santiagoatejeda/Pleper/Imágenes Proyecto/Desarrollo/Tareas manuales/Agujerear la placa de caucho.jpg

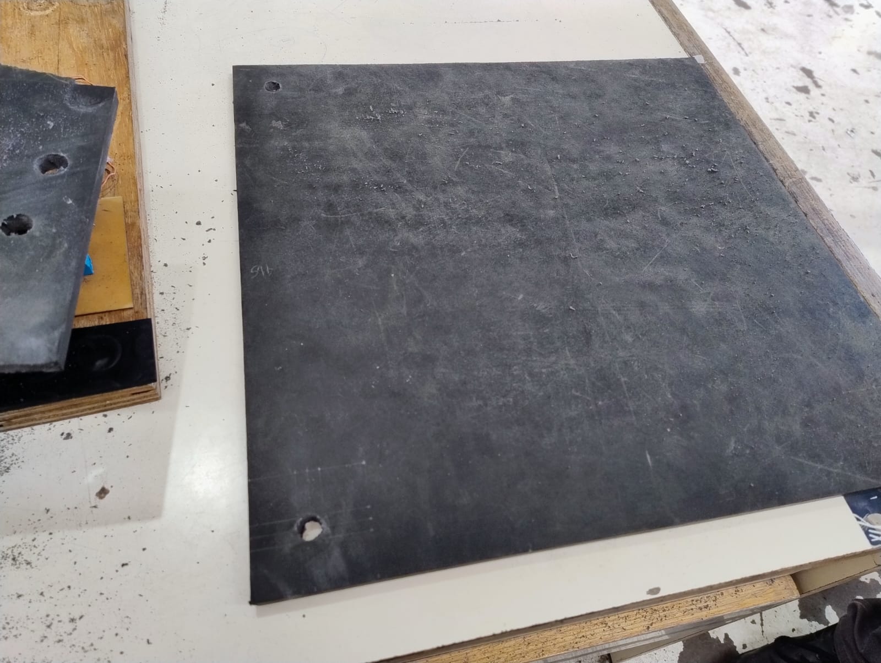
Imágenes Proyecto/Desarrollo/Tareas manuales/Agujerear la placa de caucho.jpg
