santiagoatejeda/Pleper/Diseño de placas/readme.md

# Carpeta: Diseño de Placas

> Módulos electrónicos del proyecto

---

## Contenido
- `Banco de capacitores/` → Conjunto de capacitores conectados en paralelo para almacenamiento de energía.  
- `Diseño 3D/` → Modelado tridimensional del banco de capacitores y disposición general.  
- `Placa rectificadora/` → Conversión de corriente alterna a continua para carga estable en la batería.
- `Raspberry (Placa para el display)` → Mostrar la tensión generada y crear una página para mostrarla.  
- `Segunda placa rectificadora` → Conversión de corriente alterna a continua para carga estable; placa para la segunda baldosa.
  
---

## Descripción
En esta carpeta se encuentran los **diseños electrónicos** fundamentales del sistema:  
- Implementación de **etapas de rectificación y almacenamiento**.  
- Integración entre módulos para alimentar el sistema de medición y visualización.  

---

## Herramientas utilizadas
- **KiCad** para diseño de PCBs.  
- **PDFGear** para visualización e impresión.
---
