santiagoatejeda/Pleper/Diseño y modelos 3D/readme.md

# Carpeta: Diseño y modelos 3D

> Planos y diseños del proyecto
> Realizados en **AutoCAD** para el modelado y la disposición del sistema piezoeléctrico.

---

## Descripción
Aquí se desarrollan los **planos 2D y modelos 3D** del prototipo:  
- Distribución de sensores piezoeléctricos   
- Soporte mecánico y otros elementos en impresión 3D
- Cables, conexiones y espacio para batería   

---

## Herramientas utilizadas
- AutoCAD 2025  
- FreeCAD (para pruebas de exportación STEP)
