santiagoatejeda/Pleper/Documentos Proyecto/readme.md

# Carpeta: Documentos del Proyecto

> Archivos y registros del proyecto  
> Incluye documentación técnica, bitácoras, materiales de referencia y presentaciones finales.

---

## Contenido
- `Anteproyecto, Objetivos e Historias de Usuario` → Primeros documentos técnicos que buscaban guíar hacía donde iría el desarrollo del proyecto.  
- `Bitácora y Carpeta de Campo/` → Registro cronológico del avance mensual y tareas realizadas.  
- `CV Alumnos/` → Curriculum de los integrantes del proyecto.  
- `Carpeta Técnica y Manual de Usuario/` → Documentación técnica explicativa sobre el proyecto.  
- `Compras/` → Comprobantes, presupuestos y control de materiales adquiridos.    
- `Material/` → Referencias teóricas, papers y fuentes consultadas.  
- `Video de presentación/` → Guion, recursos y edición del video final del proyecto.  

---

## Herramientas utilizadas
- Microsoft Word y PowerPoint  
- Canva (diseño visual del material)  
- Google Drive
- Excel
