santiagoatejeda/Pleper/Imágenes Proyecto/readme.md

# Carpeta: Imágenes del Proyecto

> Registro visual del proyecto
> Fotografías, capturas y material gráfico que documenta cada etapa de desarrollo.

---

## Contenido
- `Desarrollo/` → Imágenes del prototipo en construcción y pruebas de funcionamiento.  
- `Referencias/` → Material visual de apoyo, esquemas base y ejemplos consultados.  
- `Instagram/` → Contenido audiovisual editado para difusión del proyecto.  

---

## Descripción
Esta carpeta concentra todo el **material gráfico y visual** del proyecto, utilizado tanto para documentación técnica como para difusión.  
Incluye: fotos del armado y conexión de placas, imágenes promocionales y contenido para redes  

---
