santiagoatejeda/Pleper/Documentos Proyecto/Elementos de alcance inconclusos.docx

Elementos de alcance inconclusos

Enunciado

El alcance de un proyecto se refiere al conjunto de límites y fronteras que definen lo que se incluye y lo que no se incluye en un proyecto específico. Estos límites pueden estar relacionados con el tiempo, los recursos, las funciones y las características del producto o servicio a desarrollar. En otras palabras, el alcance del proyecto establece los límites y las expectativas para el trabajo que se llevará a cabo durante el ciclo de vida del proyecto.

En el camino del desarrollo del proyecto, han enfrentado desafíos significativos. Sin embargo, es crucial que reflexionemos sobre nuestro progreso hasta ahora y abordemos las tareas pendientes de manera transparente.

Con tal fin le vamos a pedir que en un documento que van a pasarnos, enumeren los diferentes elementos que quedaron afuera en cuanto a entregables y características que se esperaban el principio de desarrollo y que al final no pudieron ser llevadas a cabo. Pueden discriminar entre cada una de estas cosas el motivo asociado y la idea es que lo presenten de una manera relativamente sencilla.

Es crucial la transparencia en este punto puesto que se definirá en caso de crear cosas importantes pendientes los límites de ellas a fin de poder trabajarlo en un plazo acotado.

Elemento pendiente | Descripción breve | Motivo de no concreción
Alimentar una batería con la energía generada | Se buscaba almacenar la energía que generaba la placa en una batería para su posterior uso | La corriente generada era bastante menor a la esperada en un principio con la distribución de los piezoeléctricos, por lo que requeríamos realizar más baldosas
Mostrar en el display la energía almacenada | Poder mostrar la carga almacenada en la batería | Al no haber implementado una batería, no podemos mostrar de manera interactiva el display. Sin embargo, logramos hacer que mostrara los picos de tensión almacenados
Integración con aplicación móvil | Se esperaba mostrar datos de energía generada en una app. | Finalmente los datos pasaron a mostrarse en una web generada en el momento gracias a la pi pico 2W y conectandose a un wifi local. En esta página se podrían ver los picos de tensión que se generan en tiempo real al pisar la baldosa.
Alimentar el microcontrolador con una batería Lipo y un módulo de carga | Se esperaba alimentar la raspberry pi pico 2W con una batería Lipo y un módulo de carga. | Lo que ocurrió fue que la batería Lipo alimentaba hasta 4,1V mientras que la pico necesitaba 5V. Al querer usar una batería de mayor voltaje, experimentamos una serie de falsos contactos en el modulo de carga y al final optamos por una batería portátil.
Memoria limitada de la pico | Se esperaba crearle un apartado web a la pico para que muestre los picos de tensión en tiempo real, tanto en el display como en la página que crearía en el momento. | Hubo un problema y era que nuestra idea del apartado web era mostrar los picos de tensión, que los picos mayores a 1V se congelen por un breve tiempo (para que la gente lo pueda ver) y agregar una grafica para que la gente vea de forma mas interactiva los picos de tensión que generaba. El grafico no lo pudimos hacer con buenas características o mas complejo (como especificaciones técnicas) por la limitada memoria que experimento la pi pico 2W.
Presentar nuestro prototipo en las ONIET | buscábamos poder presentar nuestro prototipo en las ONIET | Debido a un problema de tiempos, no llegábamos preparados para presentar en optimas condiciones el prototipo para la exposición de las ONIET. Finalmente llegamos a exponer en condiciones para la feria anual del IMPA, pero a las ONIET no pudimos llegar.
Hacer mas baldosas | Hacer mas baldosas para poder cargar el cartel de salida de emergencias | El objetivo inicial era mostrar el cartel de salida de emergencias prendido por la carga de energía proveniente de las baldosas, sin embargo, requeríamos de una cantidad mayor de baldosas para cumplir dicho objetivo. Finalmente decidimos únicamente mostrar los picos de tensión generados.
