santiagoatejeda/Pleper/Documentos Proyecto/CV Alumnos/Currículum Vitae de Isidro Stabile.pdf

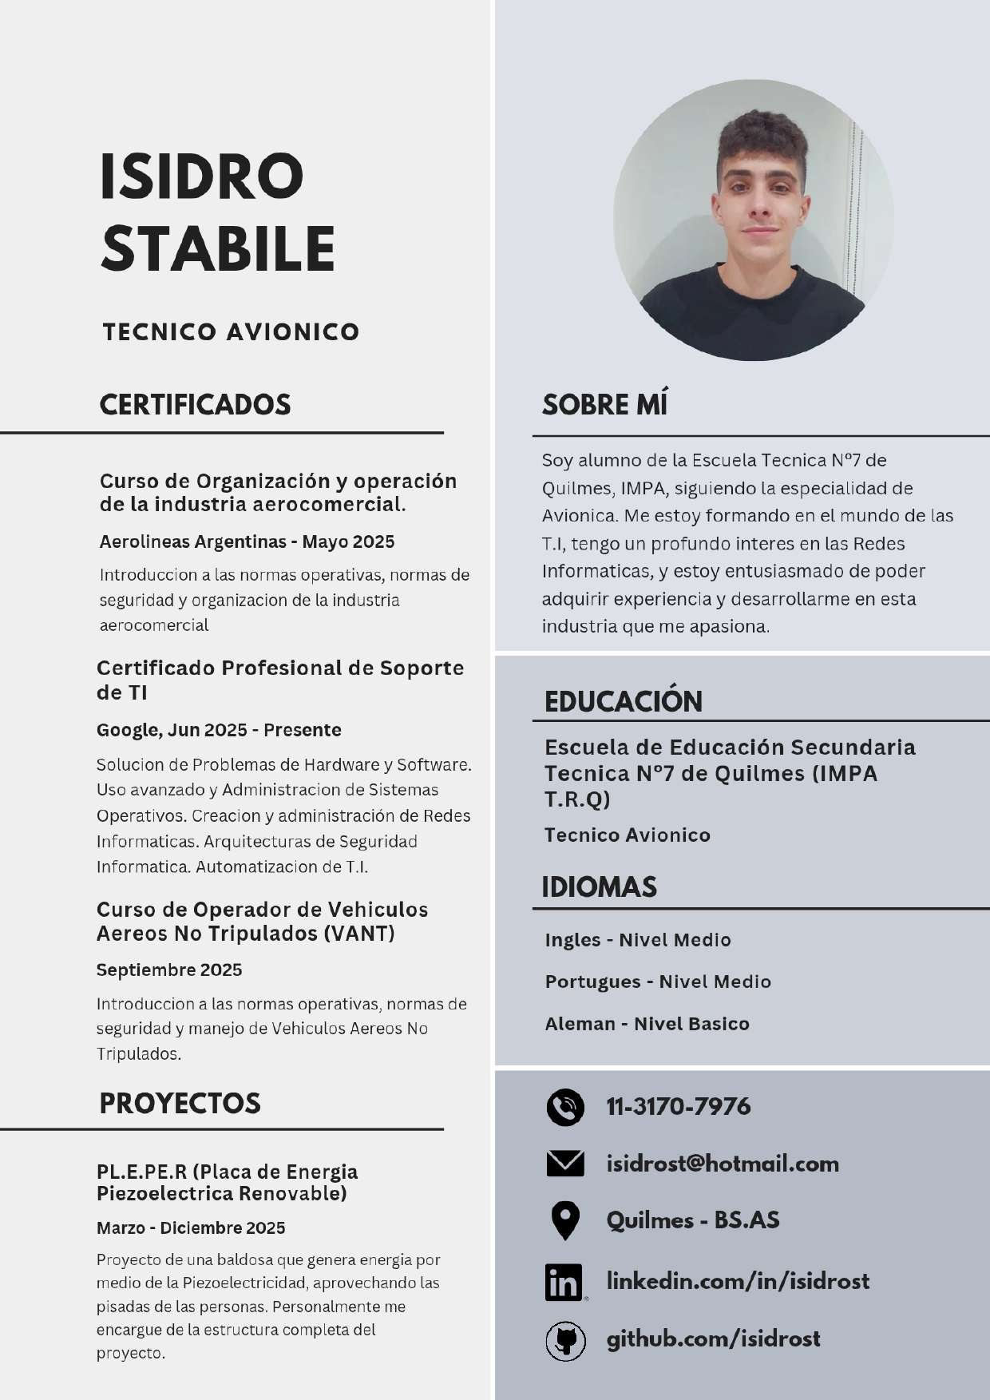
[picture p3: page 1]
