santiagoatejeda/Pleper/Imágenes Proyecto/instagram/Presentaciones Pleper/presentacion avances primer cuatrimestre.pdf

# 7mo 1av com c

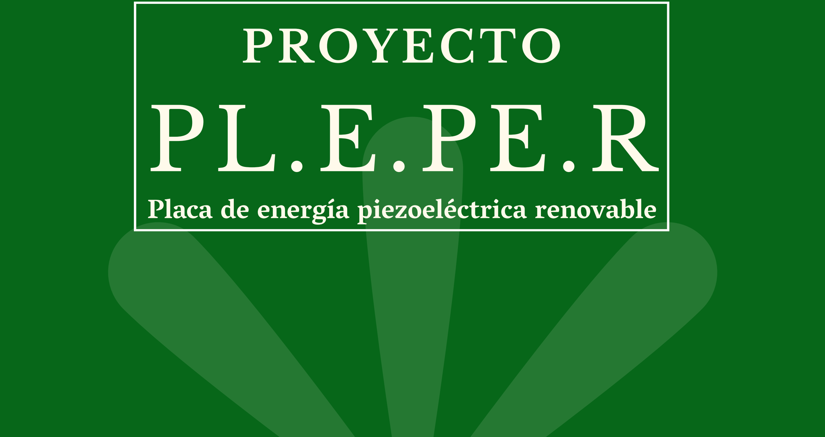
[picture p4: figure]
PROYECTO

# Placa de energía piezoeléctrica renovable

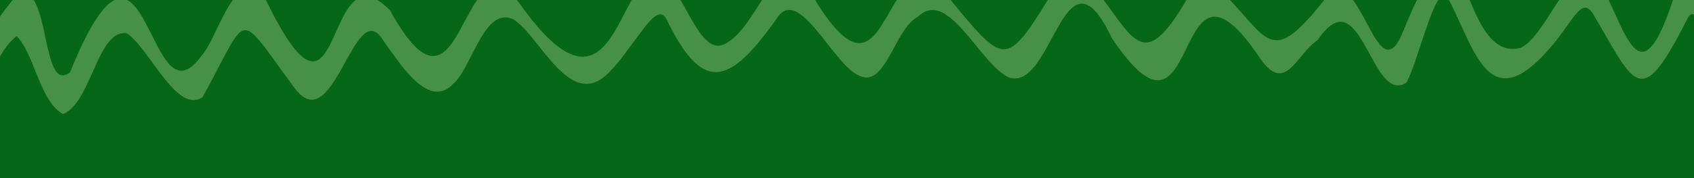
[picture p5: figure]
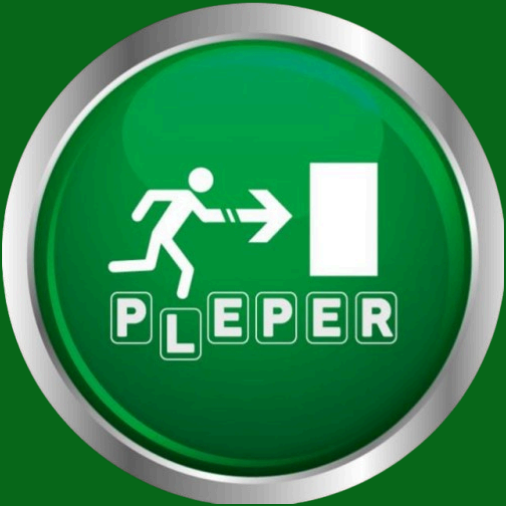
[picture p6: figure]

# ¿QUÉ ES PLEPER?

### PL.E.PE.R es un proyecto que se centra en diseñar y construir una placa piezoeléctrica capaz de generar energía aprovechando la presión ejercida por el paso de personas

### La energia que se obtiene es almacenada para ser usada en caso de emergencia para iluminar carteles de advertencia

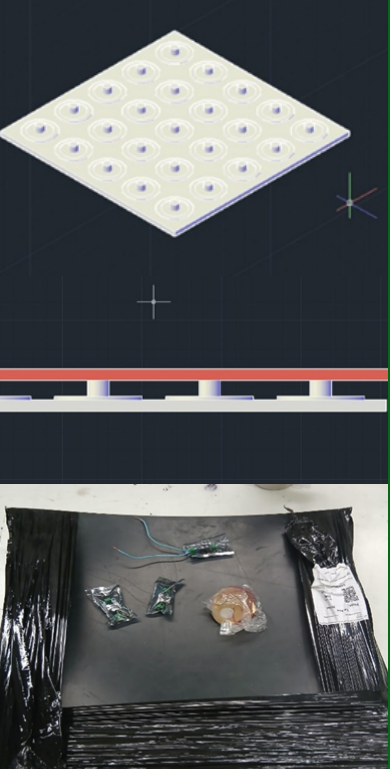
[picture p7: figure]

# ¿CÓMO HA AVAZANDO EL PROYECTO?

## Por ahora contamos con varios puntos cruciales en el

desarrollo como el diagrama del circuito en general,

## junto sus mediciones, diseños en 3D de la estructura de la baldosa y contamos con gran parte de materiales necesarios para la construcción de la

placa.

# ¿CÓMO HA AVAZANDO EL PROYECTO?

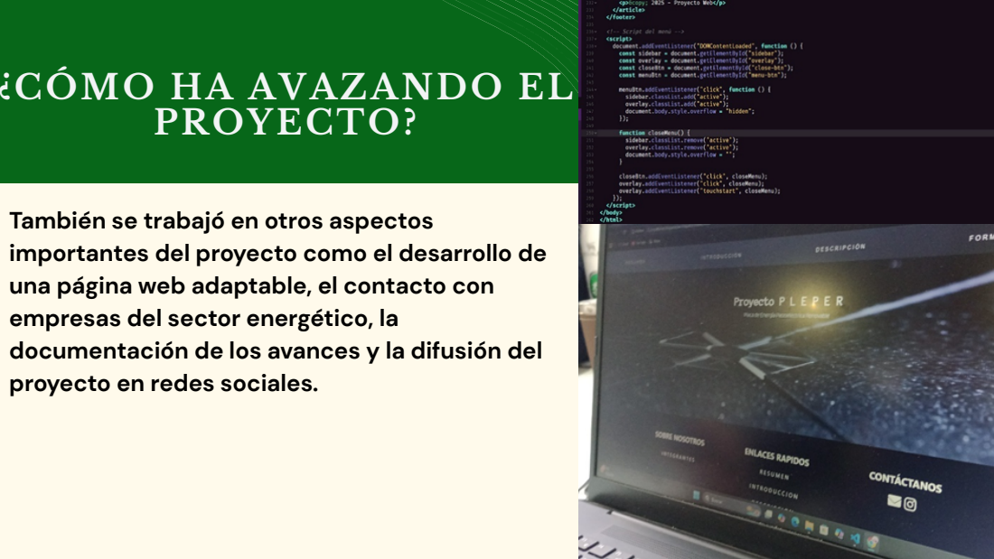
[picture p8: page 4]

También se trabajó en otros aspectos
importantes del proyecto como el desarrollo de
una página web adaptable, el contacto con
empresas del sector energético, la
documentación de los avances y la difusión del
proyecto en redes sociales.

# DE QUE SE ENCARGA CADA INTEGEANTE

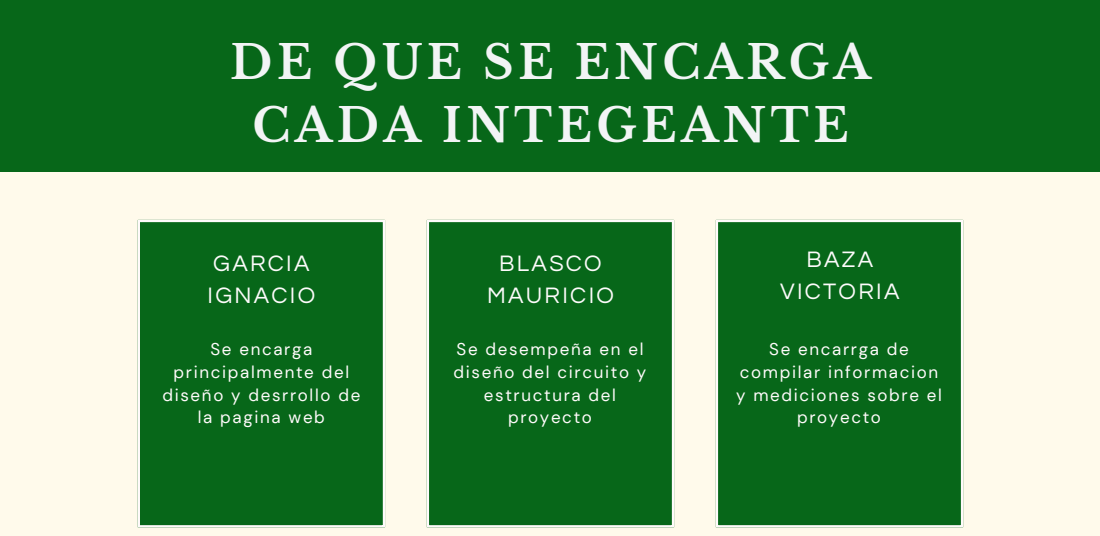
[picture p9: page 5]
GARCIA IGNACIO; BLASCO MAURICIO; BAZA VICTORIA

Se encarga
principalmente del
diseño y desrrollo de
la pagina web

Se desempeña en el
diseño del circuito y
estructura del
proyecto

Se encarrga de
compilar informacion
y mediciones sobre el

# DE QUE SE ENCARGA CADA INTEGEANTE

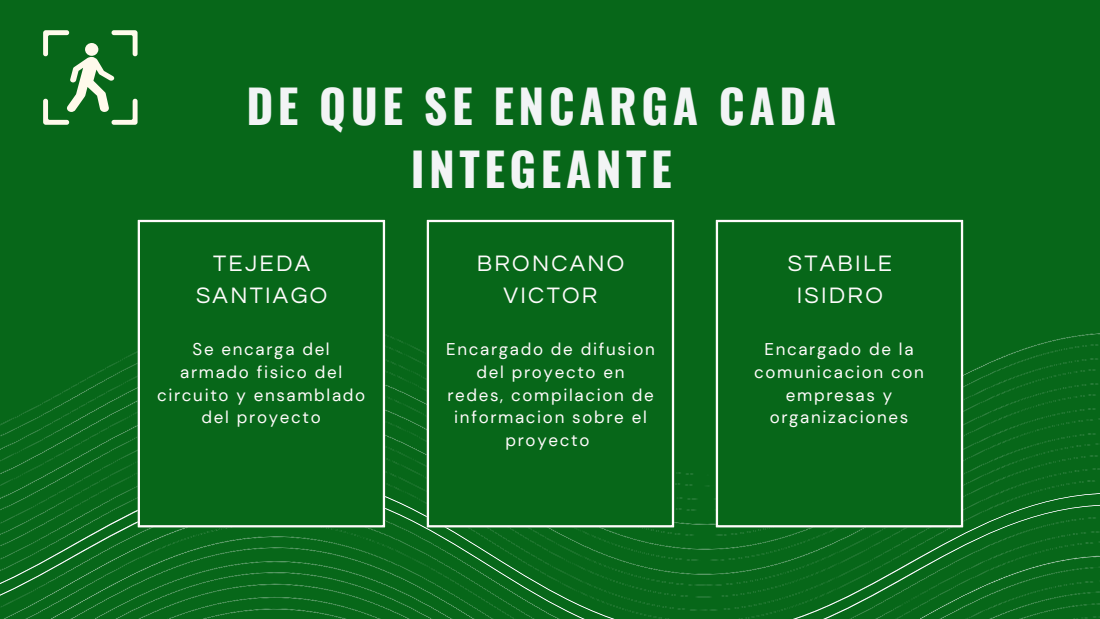
[picture p10: page 6]
TEJEDA SANTIAGO; BRONCANO VICTOR; STABILE ISIDRO

Se encarga del
armado fisico del
circuito y ensamblado
del proyecto

Encargado de difusion
del proyecto en
redes, compilacion de
informacion sobre el
proyecto

Encargado de la
comunicacion con
empresas y
organizaciones

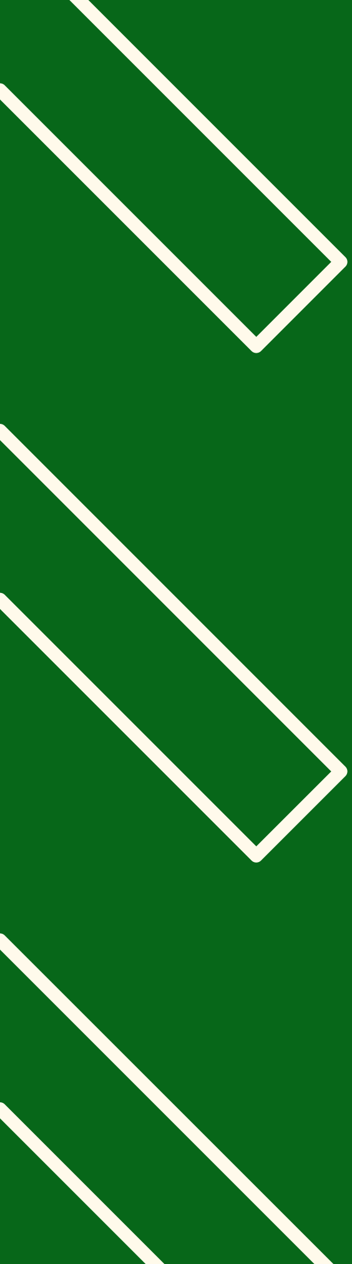
[picture p11: figure]

# PL.E.PE.R

# Energia en cada paso

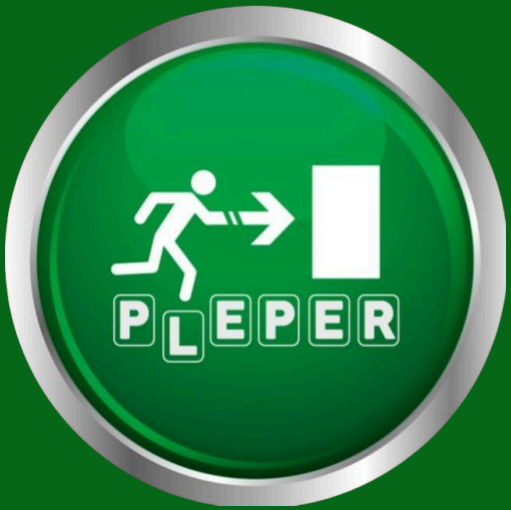
[picture p12: figure]
