santiagoatejeda/Pleper/Imágenes Proyecto/instagram/Presentaciones Pleper/Foto de presentaciones.jpg

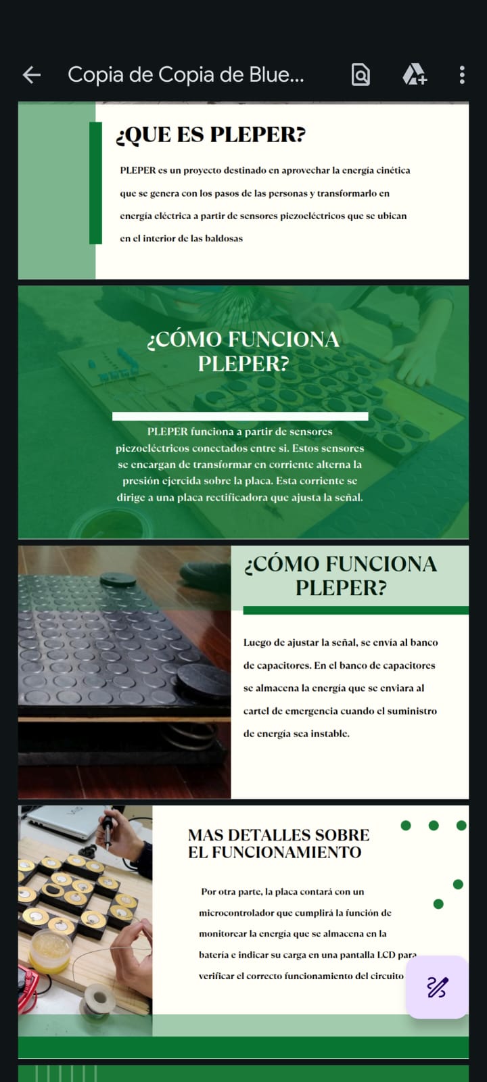
Imágenes Proyecto/instagram/Presentaciones Pleper/Foto de presentaciones.jpg
