santiagoatejeda/Pleper/Imágenes Proyecto/Desarrollo/Tareas manuales/Agujerear baldosa de madera.jpg

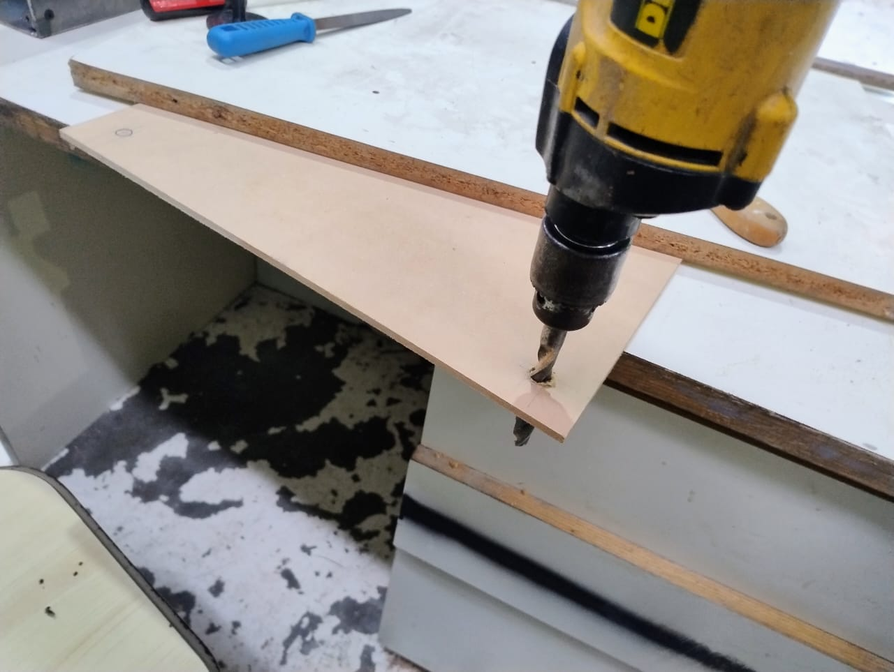
Imágenes Proyecto/Desarrollo/Tareas manuales/Agujerear baldosa de madera.jpg
