santiagoatejeda/Pleper/Imágenes Proyecto/Desarrollo/Tareas manuales/Cortando el tubo de PVC para ajustar la altura del cartel.jpg

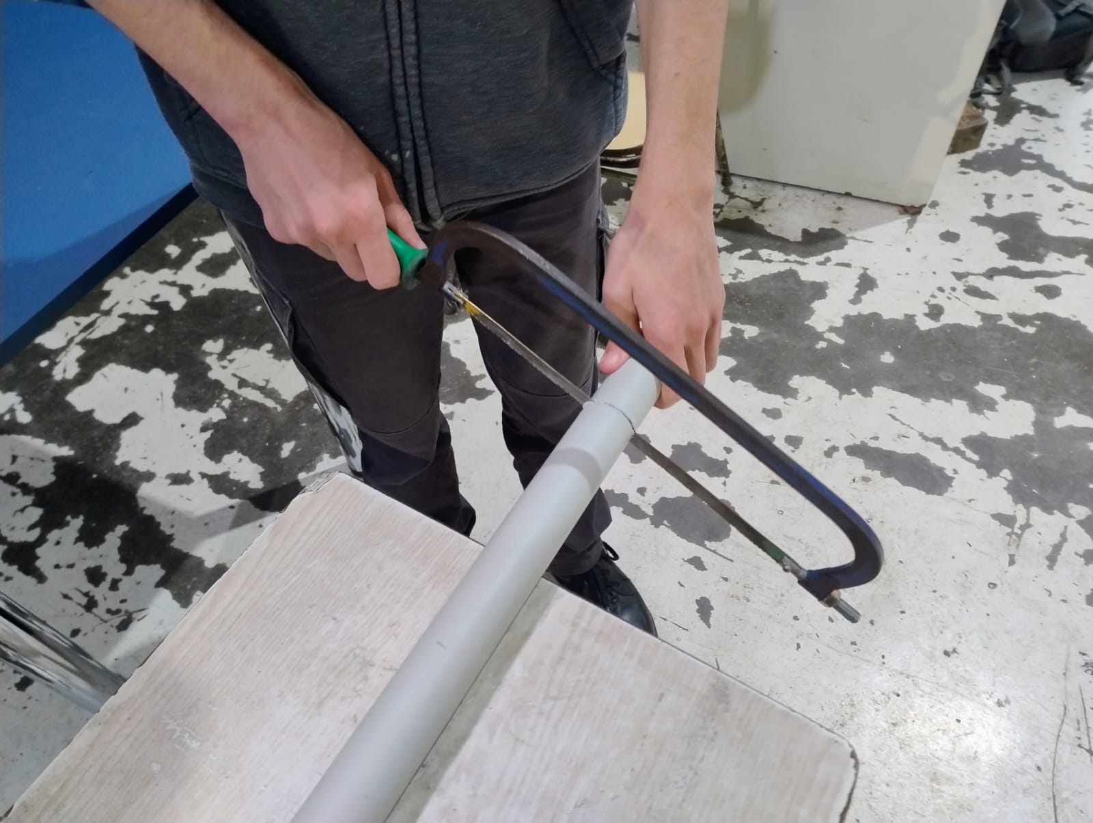
Imágenes Proyecto/Desarrollo/Tareas manuales/Cortando el tubo de PVC para ajustar la altura del cartel.jpg
