santiagoatejeda/Pleper/Imágenes Proyecto/Desarrollo/Tareas manuales/Cortando las bases de goma eva de los piezoelectrocos.jpg

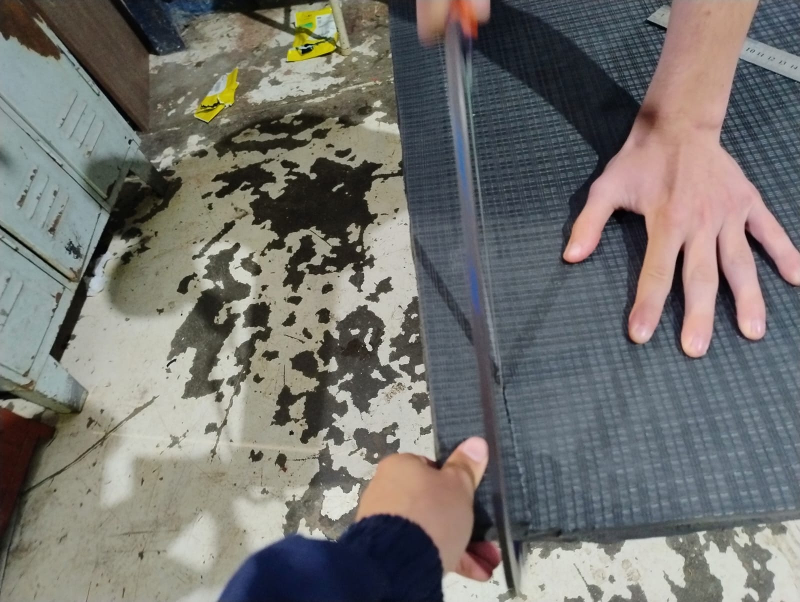
Imágenes Proyecto/Desarrollo/Tareas manuales/Cortando las bases de goma eva de los piezoelectrocos.jpg
