santiagoatejeda/Pleper/Imágenes Proyecto/Desarrollo/Tareas manuales/Cortando los soportes para la estructura.jpg

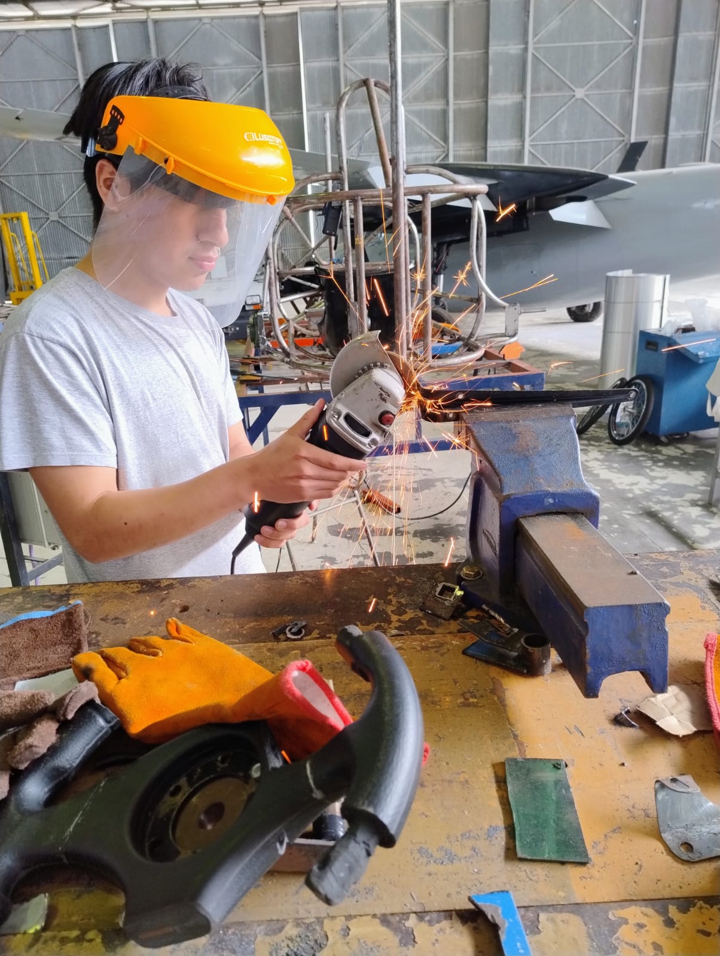
Imágenes Proyecto/Desarrollo/Tareas manuales/Cortando los soportes para la estructura.jpg
