santiagoatejeda/Pleper/Imágenes Proyecto/Desarrollo/Tareas manuales/IMG-20251117-WA0004.jpg

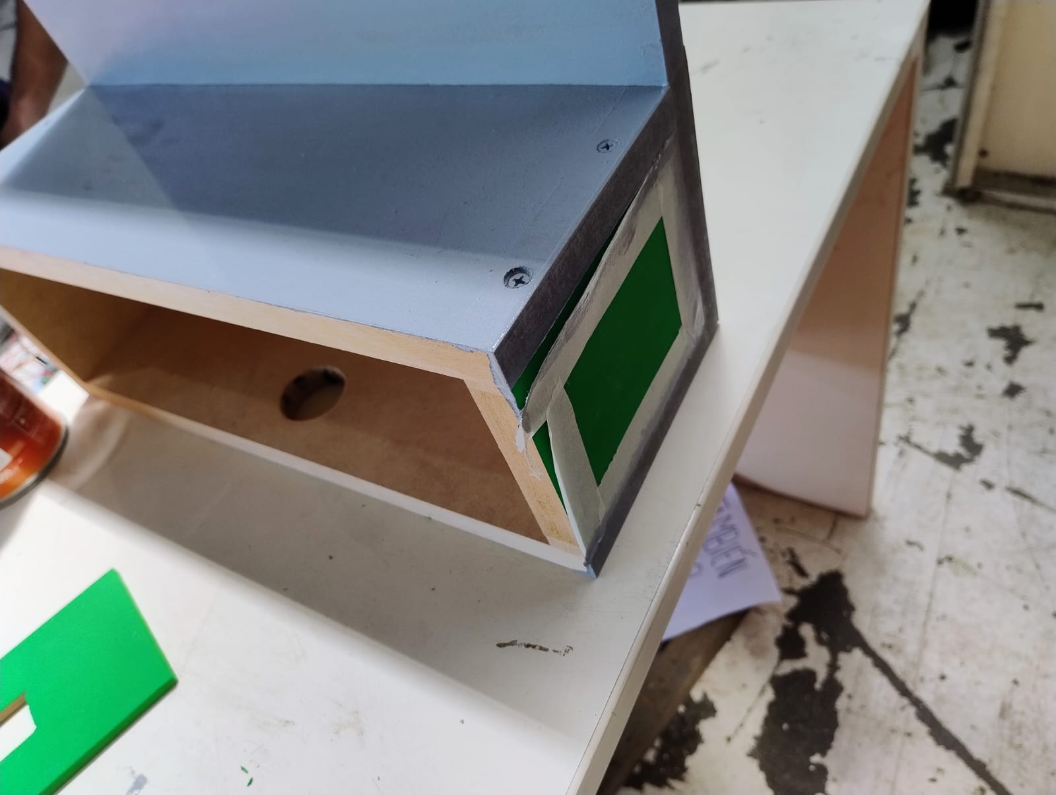
Imágenes Proyecto/Desarrollo/Tareas manuales/IMG-20251117-WA0004.jpg
