santiagoatejeda/Pleper/Imágenes Proyecto/Desarrollo/Tareas manuales/Lijado de topes impresos en 3d.jpg

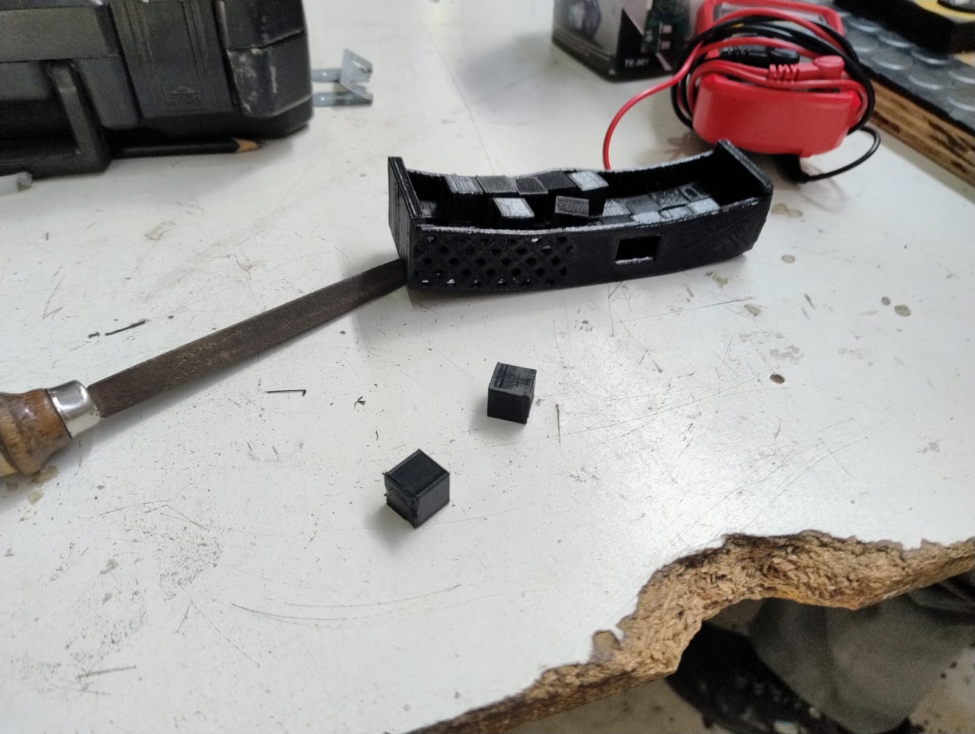
Imágenes Proyecto/Desarrollo/Tareas manuales/Lijado de topes impresos en 3d.jpg
