santiagoatejeda/Pleper/Imágenes Proyecto/Desarrollo/Tareas manuales/Pegar con adhesivo de contacto la baldosa de madera con la placa de caucho.jpg

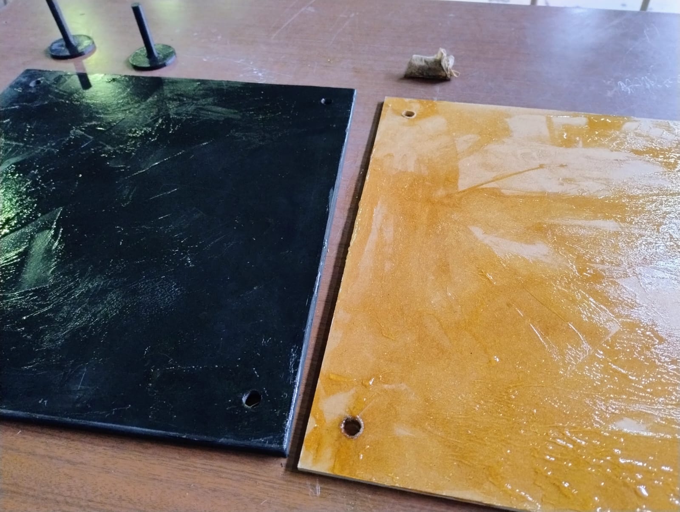
Imágenes Proyecto/Desarrollo/Tareas manuales/Pegar con adhesivo de contacto la baldosa de madera con la placa de caucho.jpg
