santiagoatejeda/Pleper/Imágenes Proyecto/Desarrollo/Tareas manuales/Pintar los bordes de la primera baldosa con aerosol.jpg

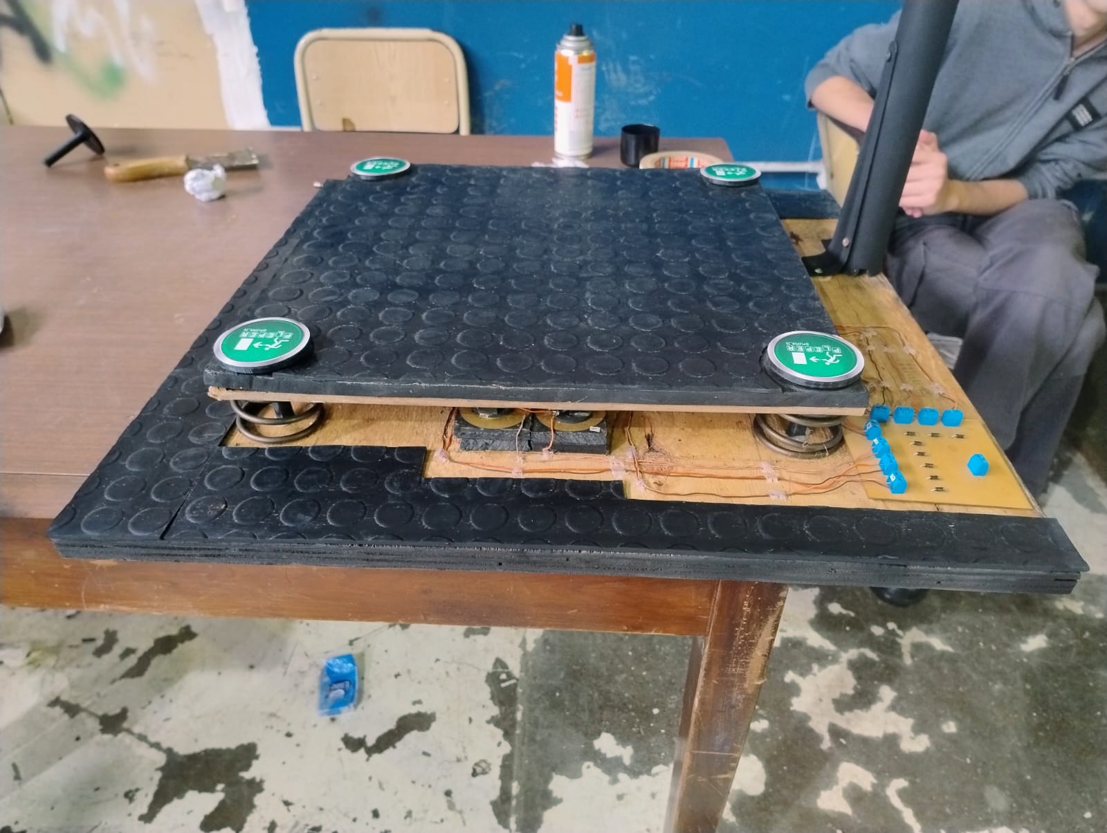
Imágenes Proyecto/Desarrollo/Tareas manuales/Pintar los bordes de la primera baldosa con aerosol.jpg
