santiagoatejeda/Pleper/Documentos Proyecto/Bitácora y Carpeta de Campo/Noviembre.md

# 🗓️ Bitácora - Noviembre 2025

## 📅 1️⃣ Semana (Lunes 3 - Viernes 7)
-  Mauricio Blasco: Esta semana me contacte con una carpinteria para poder obtener una madera de medidas de 42x42, ademas de conseguir la caja de madera la cual posteriormente tuvimos que modificar. Me encargue de arreglar el video de presentacion, grabando las ultimas partes y corrigiendo los ultimos errores ademas de diseña cambios en el guion. Por ultimo nos sacamos la foto grupal del proyecto y ayude a redactar la parte de la estructura de la carpeta tecnica.

- Santiago Tejeda: Me encargué de conseguir la placa de madera de pino de 42x42 que sería la base de la segunda baldosa. También estuve armando la segunda baldosa que a comparación de la primera va a tener una conexión en serie a modo de sumar sus tensiones pico, al ser de 16 piezoeléctricos armé 4 grupos en serie, que luego de sus conexiones fueron a una nueva placa rectificadora de 4 borneras y  de salida. Llegó a generar unos picos de 15V en su salida común.

- Ignacio Garcia Louzan: Esta semana tuve problemas con la memoria de la pico, especificamente con su apartado HTML. Yo queria que en la web que se muestra en tiempo real los picos de tension, tambien este el grafico pero con todas sus especificaciones y detalles tecnicos dentro pero el problema era que la pico almacenaba y distribuia su memoria en funcion de su conveniencia. Que quiere decir esto? Que si aparecia el grafico con sus especificaciones y detalles tecnicos, los picos de tension superiores a 1V no se congelaban (y por lo tanto las pisadas de las personas se mostraban cada 0.5 segundos y pasaban desapercibidos con el ruido) y si forzaba el congelamiento de los picos de tension, el grafico se mostraba sin las especificaciones y detalles tecnicos. Finalmente, deje el grafico en un estado basico pero igualmente interactivo para las personas.

---

## 📅 2️⃣ Semana (Lunes 10 - Viernes 14)
-  Mauricio Blasco: Diseñe el folleto que entregaremos en la muestra, tambien diseñe y contacte una empresa para poder elaborar las remeras del proyecto. Me encargue de la impresion de los folletos y de las tarjetas que entregaremos el dia de la muestra. Me comunique con autogomas bernal para poder obtener nuevamente su apoyo obteniendo una alfombra de caucho de 70x140.

- Santiago Tejeda: Estuve probando las conexiones de las baldosas entre sí. Ayudé con el armado de la estructura para la exposición, ya que tuvimos problemas para colocar la caja de placas sobre el tubo PVC, también con la alimentación de la raspberry pi 2w que solucionamos alimentandola con un powerbank royalcell.

- Ignacio Garcia Louzan: Esta semana se dedicó a pulir detalles: revisar la web, mejorar animaciones, asegurar que el servidor web funcionara de forma fluida y hacer pruebas completas. Durante la feria expliqué el funcionamiento técnico a visitantes, profesores y evaluadores. Surgieron preguntas interesantes sobre inflamabilidad, materiales alternativos, funcionamiento de la etapa rectificadora y visualización en tiempo real. El sistema funcionó correctamente durante toda la exposición.

---

## 📅 3️⃣ Semana (Lunes 17 - Viernes 21)

---

## 📅 4️⃣ Semana (Lunes 24 - Viernes 28)

---

🧾 **Observaciones generales del mes:**  
-  
-
