santiagoatejeda/Pleper/Documentos Proyecto/Bitácora y Carpeta de Campo/Agosto.md

# 🗓️ Bitácora - Agosto 2025

## 📅 1️⃣ Semana (Lunes 4 - Viernes 8)

-  Santiago Tejeda: Esta semana me encargué de investigar qué método de almacenamiento iba a ser el más adecuado para almacenar los pulsos generados por la baldosa. Primero pensamos en utilizar baterías de litio pero no tenía mucho sentido utilizar una batería de litio para cargar otra batería de litio así que seguimos investigando.

-  Isidro Stabile: Esta semana hice mediciones y corte la placa de caucho que compramos para avanzar con la estrucutura.

-  Victor Raul Broncano: Medidas y recorte del caucho que va a ser la baldosa. Esta baldosa la recotamos a una medida de 42cm*42cm ya que va a ir junto a una madera de la misma medida.

-  Maurcio Blasco: comienzo a diseñar un modelo 3D en autocad del diseño de la baldosa en el moemento, diseñando de la forma mas eficiente la estructura.

-  Ignacio Garcia Louzan: Empecé a consolidar el código en C para medir la tensión del capacitor y mostrarla en el LCD. Organicé mejor las funciones para que cada una cumpla un rol claro: leer el ADC, convertir a voltaje y porcentaje, y mostrar en pantalla. También inicié la implementación del sistema para detectar picos de tensión, que más adelante sería clave para mostrar valores máximos. Apareció un error común: los picos se reiniciaban solos porque estaba usando una variable local que se reinicializaba en cada ciclo, lo que me obligó a reorganizar las variables globales.
---

## 📅 2️⃣ Semana (Lunes 11 - Viernes 15)

-  Santiago Tejeda: Pensamos en utilizar una batería de plomo ácido ya que parecía la opción más clara para el almacenamiento. Entonces nos pusimos a buscar posibles sponsors para conseguir la batería ya que comprar una por cuenta propia iba a ser muy costoso. Investigando nos dimos cuenta que iba a necesitar un control de carga para proteger la batería y su vida útil. Teniendo en cuenta en el problema que nos metiamos optamos por elegir otro método de almacenamiento.

-  Isidro Stabile: Me comunique con Elemon, siguiendo la conversación que teniamos, y contacte con otras empresas y distruibuidoras de electronica para conseguir componentes.

-  Victor Raul Broncano: calculo y colocacion de piezoelectricos. Tambien relice mediciones y pruebas con los resortes probando como se comporta con el peso de una persona. Estas mediciones las realizamos poniendo los cuatro resortes abajo de la madera que va a ser la baldosa.
-  Mauricio Blasco: ternino de diseñar el modelo 3D de la baldosa en autocad, ademas de agregarle las texturas con el objetivo de hacerlo mas realista.

-  Ignacio Garcia Louzan: Esta semana inicié oficialmente la parte del servidor web integrado en la Raspberry Pi Pico 2W. Pude servir una página HTML sencilla con valores extraídos del ADC. Configuré la conexión WiFi de la Pico para que se conectara automáticamente a la red. Durante esta semana aparecieron varios errores: la Pico se reiniciaba constantemente por no ejecutar correctamente cyw43_arch_init(), y el HTML dentro del código C se rompía por no escapar ciertos caracteres. Fue la primera vez que el proyecto logró combinar hardware y conectividad.
---

## 📅 3️⃣ Semana (Lunes 18 - Viernes 22)

-  Santiago Tejeda: El método que optamos por elegir fue el de fabricar un banco de capacitores que me permita almacenar los pulso de los piezoelectricos, por lo que me dediqué a investigar los valores posibles de capacitancia que iba a necesitar para armarlo, ya que primero pesamos en usar un supercapacior de 1 Faradio pero estos mismos son muy costosos y llegué a la conclusión de que podía usar uno de menor valor.

- Isidro Stabile: Esta semana comenze con el armado y corte de unos "tacones" o bases para los discos piezoelectricos, que sirven para que llegen a deformarse cuando hay pisadas.

- Victor Raul Broncano: Medidas para la colocacion y corte de las bases de cauchos para los sensores piezoelectricos. Estos permiten que, cuando una persona pise la placa, los sensores lleguen a tener contacto con la baldosa.

- Mauricio Blasco: Investigue que medidas de resortes requeriamos para el correcto funcionamiento del circuito, y contacte con Resortecnica en busca de ayuda con informacion sobre los resortes.

- Ignacio Garcia Louzan: Comencé a diseñar seriamente la interfaz web de PLEPER. Agregué un fondo visual, secciones organizadas, tipografías más modernas y el video introductorio. Implementé también el sistema del menú que aparece al scrollear hacia arriba, pero únicamente en computadoras. Este detalle fue importante para mejorar la experiencia de usuario. Algunos problemas surgieron al intentar reproducir el video automáticamente y al ajustar el comportamiento responsive entre móviles y PC.
---

## 📅 4️⃣ Semana (Lunes 25 - Viernes 29)

-  Santiago Tejeda: Investigué los valores posibles para el banco de capacitores, ya que tenia que estar dentro del presupuesto y tenía que ser de óptimo funcionamiento, así gracias al pañol de aviónica que nos brindó 4 capacitores de 10.000 uF pudé crear la placa de almacenamiento, que serían los 4 capacitores en paralelo con 2 borneras, una de entrada y otra de salida.

-  Isidro Stabile: Esta semana perfeccione los contornos del caucho, y los agujeros para que puedan pasar mejor los topes impresos en 3D.

- Victor Raul Broncano: Lijado de los costados de la baldosa de caucho y de la baldosa de madera. Tambien realice mediciones para realizar las perforaciones en donde van a ir los topes en donde van a ir los resorte y mantiene las badosas alinenadas con la base de madera.
-  Mauricio Blasco: Me encargue de ralizar mediciones sobre como altera a la trensión y a la corriente las diferentes superficies de los piezoelectricos.

-  Ignacio Garcia Louzan: Hacia el final del mes logré sincronizar correctamente los datos que se muestran en el LCD con los que se ven en la página web. Organicé el código para que ambos sistemas utilicen las mismas variables globales, evitando así desfasajes o valores duplicados. También ajusté las fórmulas del divisor resistivo para obtener porcentajes precisos. Esta semana cerró con un sistema más estable, tanto en la parte visual como en la electrónica.
---

🧾 **Observaciones generales del mes:**  
-  
-
