santiagoatejeda/Pleper/Documentos Proyecto/Bitácora y Carpeta de Campo/Julio.md

# 🗓️ Bitácora - JULIO 2025

## 📅 1️⃣ Semana (Lunes 3 - Viernes 7)

- Santiago Tejeda: Me encargué de comprar herramientas para poder trabajar con el proyecto junto a la investigación de la etapa rectificadora de la baldosa piezoeléctrica.
- Ignacio Garcia Louzan: Durante la primera semana de julio me asegure de encargarme de la parte electrónica programable y la interfaz web. Eso incluía el diseño del circuito alrededor de la Raspberry Pi Pico 2W, la programación en C, la medición de tensiones provenientes de la etapa piezoeléctrica y la creación de la página web del proyecto. Esta semana estuvo enfocada principalmente en entender el funcionamiento del circuito de sensores piezoeléctricos (que ya estaba en desarrollo por el equipo de electrónica) y analizar cómo íbamos a captar esas señales y procesarlas. También empecé a investigar sobre el ADC de la Pico, sus limitaciones y la necesidad de usar un divisor resistivo para que los voltajes del capacitor no dañaran la placa. Al principio hubo mucha confusión sobre cómo medir correctamente, y también dudábamos si usar Arduino en vez de la Pico, pero lo descartamos porque necesitábamos WiFi integrado, algo fundamental para la página web.

---

## 📅 2️⃣ Semana (Lunes 10 - Viernes 14)

- Santiago Tejeda: Me dediqué a el prototipado de la etapa rectificadora junto a los sensores, midiendo con un osciloscopio su correcto funcionamiento. Primero probé un puente rectificador de onda completa con diodos 1N4007 que al tener mucha caida de tensión habían más pérdidas que tensión generada, por lo que opté por usar los diodos schottky 1n5819 que tienen una caída mucho menor, siendo esta de 0,3V.
- Ignacio Garcia Louzan: Esta semana me concentré en instalar y configurar el entorno de trabajo: VS Code, SDK de Raspberry Pi Pico, toolchain y librerías necesarias. Fue bastante complejo porque aparecieron varios errores al compilar, especialmente por la falta del archivo lwipopts.h y por rutas mal configuradas en CMakeLists.txt. Después de resolverlo, escribí el primer programa en C para probar el ADC usando el pin 26, logrando leer valores crudos. Durante las pruebas, las lecturas eran inestables, y descubrí que era porque el prototipo no tenía una masa común bien conectada. También aprendí que había que seleccionar correctamente el canal ADC antes de leer, porque si no la Pico devolvía valores repetidos o ruidosos.

---

## 📅 3️⃣ Semana (Lunes 18 - Viernes 22)
VACACIONES DE INVIERNO

---

## 📅 4️⃣ Semana (Lunes 25 - Viernes 29)
VACACIONES DE INVIERNO

---

🧾 **Observaciones generales del mes:**  
-  
-
