santiagoatejeda/Pleper/Documentos Proyecto/Bitácora y Carpeta de Campo/Septiembre.md

# 🗓️ Bitácora - Septiembre 2025

## 📅 1️⃣ Semana (Lunes 1 - Viernes 5)

-  Santiag Tejeda: Esta semana me encargué de armar un boceto a modo de guía en formato de diagrama en bloques dividiendo en etapas el proyecto, para así tener una visión más general y poder saber qué prioridades tenemos que tener en cuenta para el correcto avance del proyecto.
  
-  Isidro Stabile: Esta semana estuve actualizando la bitacora a lo largo de Agosto. Tambien estuve nuevamente contactando con Elemon, para ya acordar el listado de componentes que queremos tener bonificados, ademas de haber actualizado al dia de la fecha el tablero de Trello, con las tareas que hicimos.

-  Victor Raul Broncano: Obtencion del cemento de contacto para adherir los elementos de la estructura. Tambien nos comunicamos con Elemon, sobre el abono de componentes y elementos de trabajo.

-  Ignacio Garcia Louzan: Comence con la planificación de un sistema más complejo: medir simultáneamente la tensión de la baldosa y la de una batería LiPo. Esto implicó analizar dos divisores resistivos separados y evaluar cómo usar dos canales ADC sin que las mediciones se contaminen entre sí. Se discutieron alternativas, se evaluó la carga de procesamiento y se definió la estructura general del sistema doble.

---

## 📅 2️⃣ Semana (Lunes 8 - Viernes 12)

-  Santiago Tejeda: Esta semana me encargue de pensar la estructura del proyecto, especificamente el armado a nivel de funcionamiento, llegué a la conclusión de que ibamos a necesitar unos resortes para generar un mecanismo de suspensión para que la baldosa pueda ser pisada y esta fuerza sea transmitida a los sensores piezoeléctricos.

-  Victor Raul Broncano:  Perforar la base de madera de la estructura en donde ban a ir los colocados los sensores piezoelectricos. Y tambien pegamos las dos partes de la baldosa, la de madera con la de caucho, haciendo que coincidan las perforaciones de ambas partes.

-  Ignacio Garcia Louzan: Dediqué la semana a investigar los módulos TP4056 con y sin protección. Tuve que entender cómo funcionaba la protección contra sobrecarga, sobredescarga y cortocircuitos. También aprendí que el conector USB del TP4056 sirve únicamente para cargar la batería, no para alimentar la Raspberry directamente. Este descubrimiento resolvió varias dudas que teníamos sobre la alimentación del sistema cuando no hubiera computadora.

---

## 📅 3️⃣ Semana (Lunes 15 - Viernes 19)

-  Mauricio Blasco: fuimos al local de zona electo para comunicarnos en busca de apoyo. También realice el diseño en pcb y el esquemático de la placa de capacitores, el cual imprimimos posteriormente. Hicimos una recorrida por el centro en la búsqueda de sponsors, además de comprar placa de cobre.

-  Santiago Tejeda: Esta semana continué pensando en cómo sería la estructura de la baldosa, llegando a la conclusión de que el sistema de suspensión debía incorporar un mecanismo que permitiera pisarla y generar movimiento, pero que al mismo tiempo pudiera volver a su posición original.
Con la ayuda de los resortes y los pilares logré este objetivo: los resortes se ubicaron en las cuatro esquinas de la tapa superior de la baldosa, anclados mediante pilares impresos en 3D. Gracias a su forma, similar a un trompo, estos pilares permiten el movimiento controlado de la tapa. De esta manera, cuando se pisa la baldosa, los piezoeléctricos se comprimen, y al liberar la presión, los resortes devuelven la tapa hacia arriba, mientras la parte superior de los pilares actúa como tope para evitar que se desplace más de lo necesario.

- Victor Raul Borncano: Distribui y pegue los topes de caucho a la base de madera, y pegar los piezoelectricos arriba de los topes. Calculo de tamaño y colocacion de muelles para evitar que los resortes se desacomoden.

- Ignacio Garcia Louzan: Esta semana logré integrar ambas mediciones (baldosa + batería) al código. Sin embargo, no fue facil. El ADC devolvía lecturas ruidosas porque estaba cambiando de canal sin esperar el tiempo adecuado. También la página web mostraba los valores con retraso porque estaba procesando demasiado en cada actualización. Fue una semana de depuración, pero al final ambas lecturas quedaron estables.

---

## 📅 4️⃣ Semana (Lunes 22 - Viernes 26)

-  Mauricio Blasco: Coloque los topes de goma en los piezoeléctricos ya soldados, también me contacte con Autogomas Para recibir como ayuda una alfombra antideslizante, la cual fui a retirar y posteriormente la medimos, lijamos y recortamos para colocarla sobre la baldosa. Por ultimo diseñe el banner del proyecto, el cual enviamos. También me encargue principalmente de diseñar el esquemático y pcb de la placa rectificadora, la cual imprimimos, planchamos, pusimos en acido, lijamos y agujereamos.

-  Santiago Tejeda: Esta semana me encargué específicamente del armado de los piezoeléctricos en la baldosa, ubicándolos junto a unas tarimas de caucho que habían sobrado. Además, realicé el pegado de los mismos a la estructura y su correspondiente cableado de forma prolija con silicona, para luego conectarlos en las borneras de la placa rectificadora, cual diseñé en la misma semana.

-  Victor Raul Broncano: Compre, corte y lije la placa de cobre para despues limpiar la placa, imprimi las conexiones del banco de capacitores. Despues plancahe y puse la placa en acido.

-  Ignacio Garcia Louzan: Etsa semana organicé todo el código en funciones bien estructuradas, lo que mejoró la legibilidad y el mantenimiento. Separé las tareas de lectura, conversión, actualización del LCD y envío a la web. Esta reorganización facilitó todo lo que vendría mas adelante.

- Isidro Stabile: Esta semana diseñe el boceto de lo que sera la parte de la caja donde iran el display y la Raspberry Pi Pico 2W, y el tubo PVC que lo sostendra.

---

🧾 **Observaciones generales del mes:**  
-  
-
