santiagoatejeda/Pleper/Imágenes Proyecto/instagram/Presentaciones Pleper/Presentacion de pleper.pdf

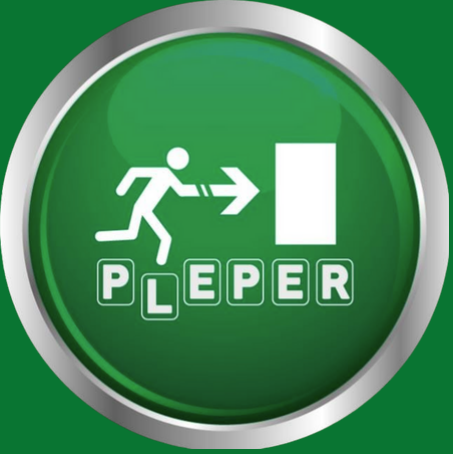
[picture p84: figure]

# PROYECTO 2025 PL.E.PE.R

Placa de Energia Piezoelectrica Renovable

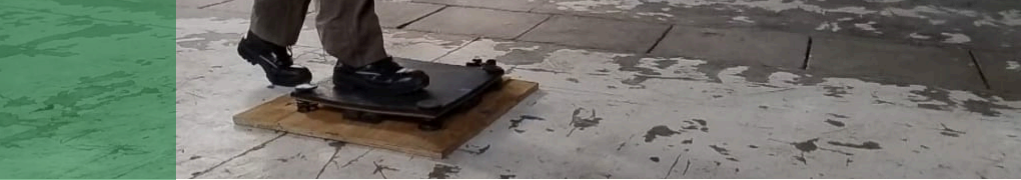
[picture p85: figure]

# ¿QUE ES PLEPER?

PLEPER es un proyecto destinado en aprovechar la energía cinética

que se genera con los pasos de las personas y transformarlo en

energía eléctrica a partir de sensores piezoeléctricos que se ubican

en el interior de las baldosas

# ¿CÓMO FUNCIONA

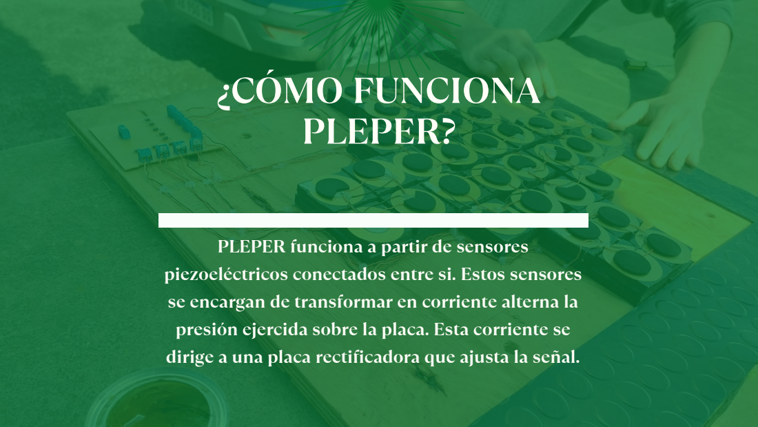
[picture p86: page 3]
PLEPER?

PLEPER funciona a partir de sensores
piezoeléctricos conectados entre si. Estos sensores
se encargan de transformar en corriente alterna la
presión ejercida sobre la placa. Esta corriente se
dirige a una placa rectificadora que ajusta la señal.

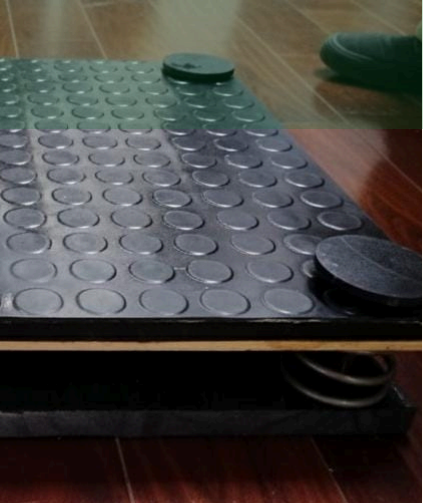
[picture p87: figure]

Luego de ajustar la señal, se envía al banco

de capacitores. En el banco de capacitores

se almacena la energía que se enviara al

cartel de emergencia cuando el suministro

de energía sea instable.

# ¿CÓMO FUNCIONA PLEPER?

# MAS DETALLES SOBRE EL FUNCIONAMIENTO

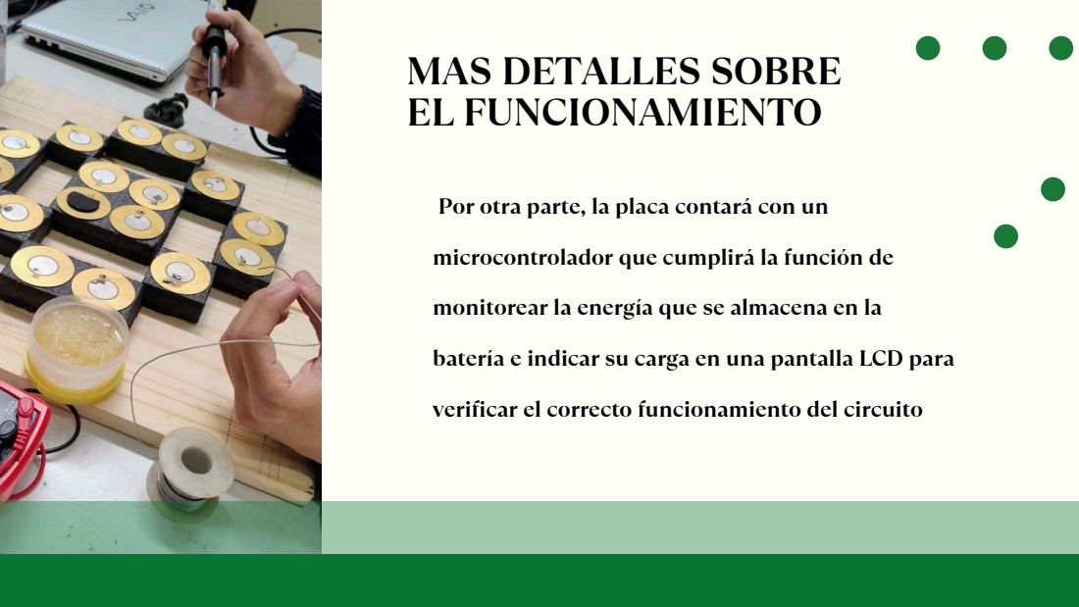
[picture p88: page 5]

Por otra parte, la placa contará con un

microcontrolador que cumplirá la función de

monitorear la energía que se almacena en la

batería e indicar su carga en una pantalla LCD para

verificar el correcto funcionamiento del circuito

# ¿QUÉ BENEFICIOS TRAE PLEPER?

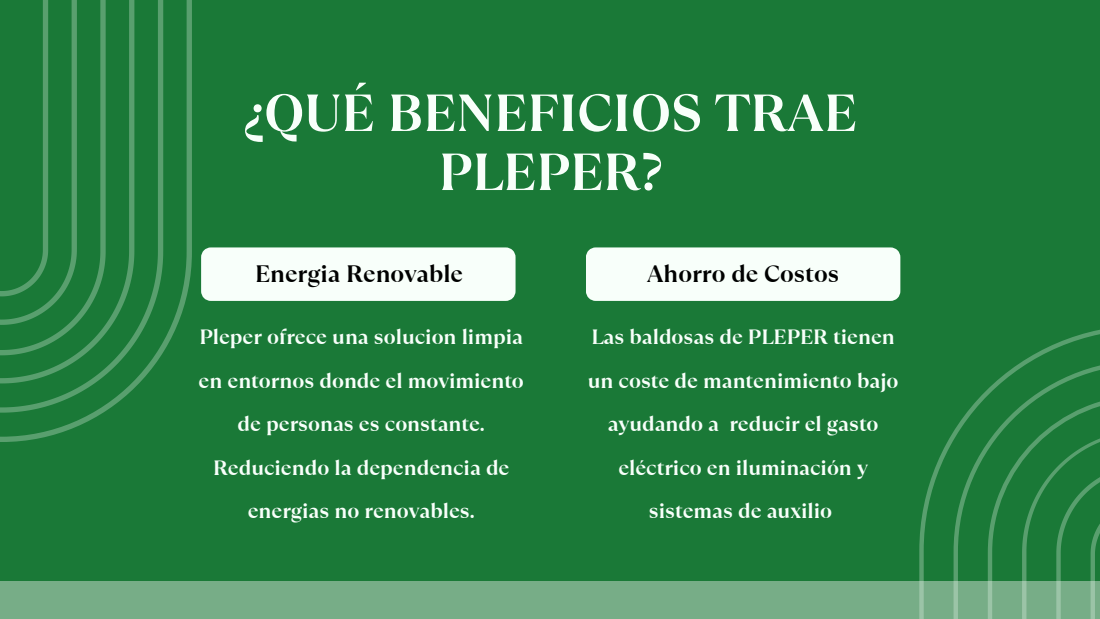
[picture p89: page 6]
Energia Renovable

Ahorro de Costos

Pleper ofrece una solucion limpia
en entornos donde el movimiento
de personas es constante.
Reduciendo la dependencia de
energias no renovables.

Las baldosas de PLEPER tienen
un coste de mantenimiento bajo
ayudando a reducir el gasto
eléctrico en iluminación y
sistemas de auxilio

# COMO SE COMPONE NUESTRO GRUPO

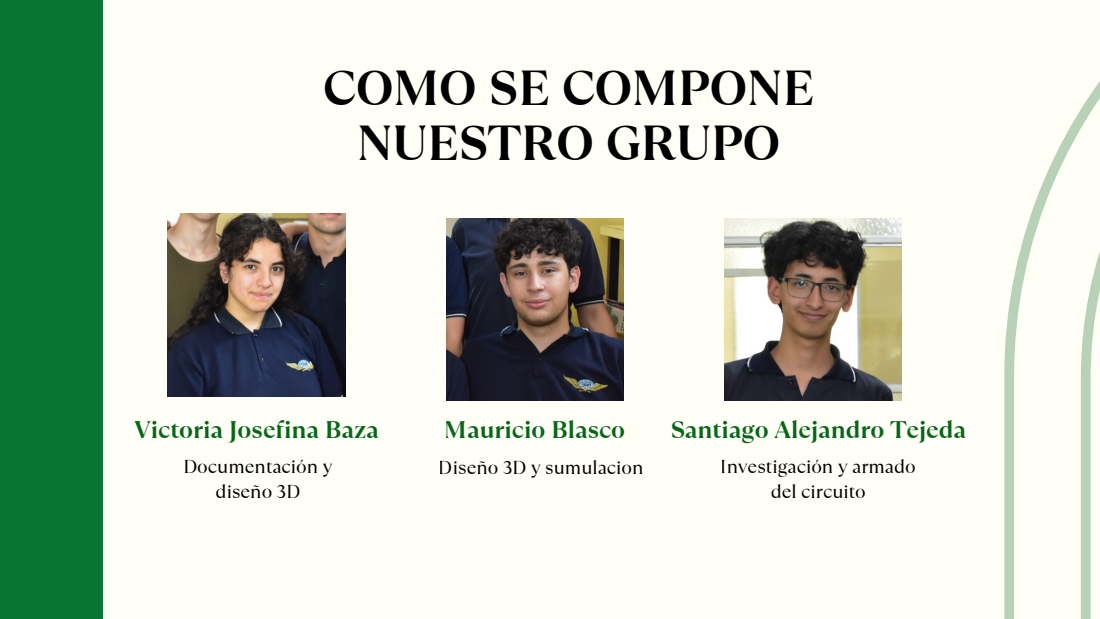
[picture p90: page 7]
Mauricio Blasco; Diseño 3D y sumulacion

Victoria Josefina Baza
Documentación y
diseño 3D

Santiago Alejandro Tejeda
Investigación y armado
del circuito

# COMO SE COMPONE NUESTRO GRUPO

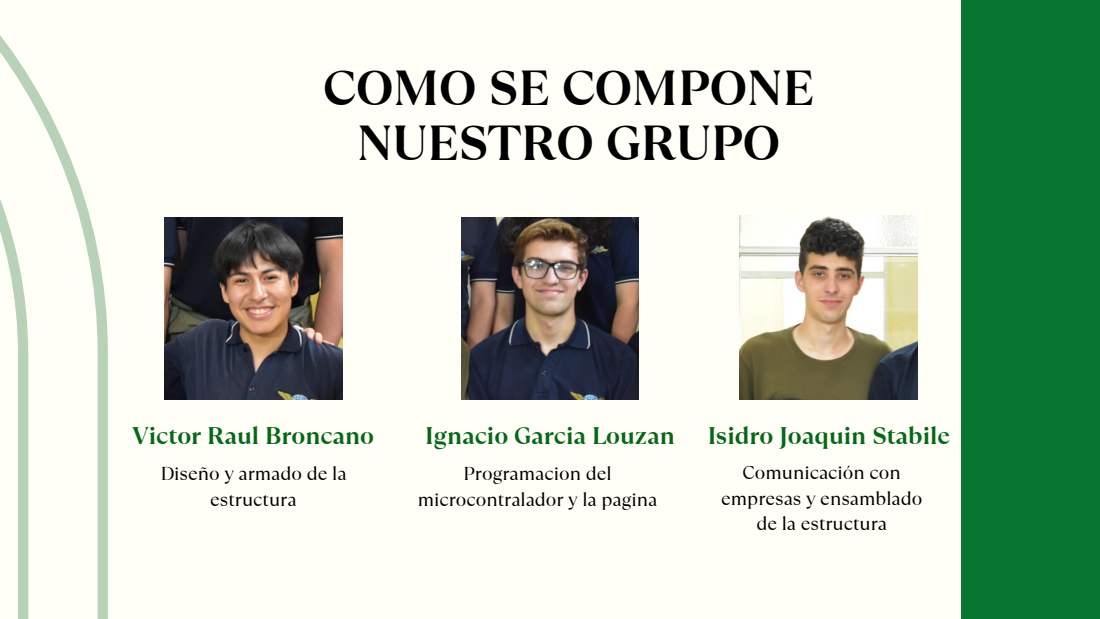
[picture p91: page 8]

Victor Raul Broncano

Ignacio Garcia Louzan

Isidro Joaquin Stabile
Comunicación con
empresas y ensamblado
de la estructura

Diseño y armado de la
estructura

Programacion del
microcontralador y la pagina

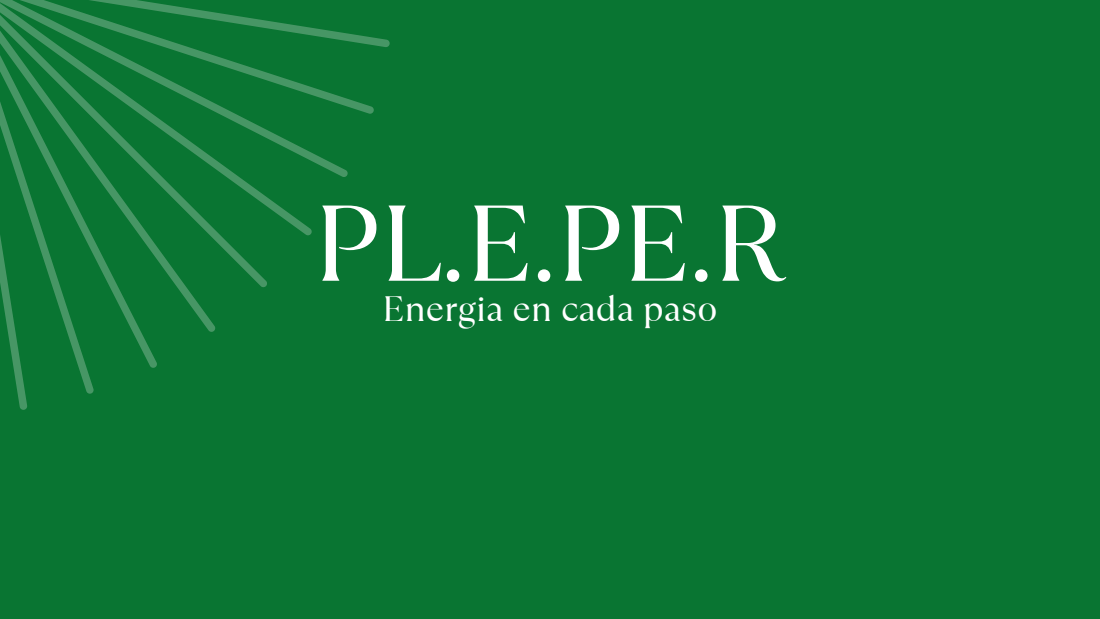
[picture p92: page 9]

PL.E.PE.R Energia en cada paso
