santiagoatejeda/Pleper/Diseño de placas/Raspberry (Placa para el display)/Raspberry.kicad_pcb

## KiCad design Diseño de placas/Raspberry (Placa para el display)/Raspberry.kicad_pcb (2025-11-17)

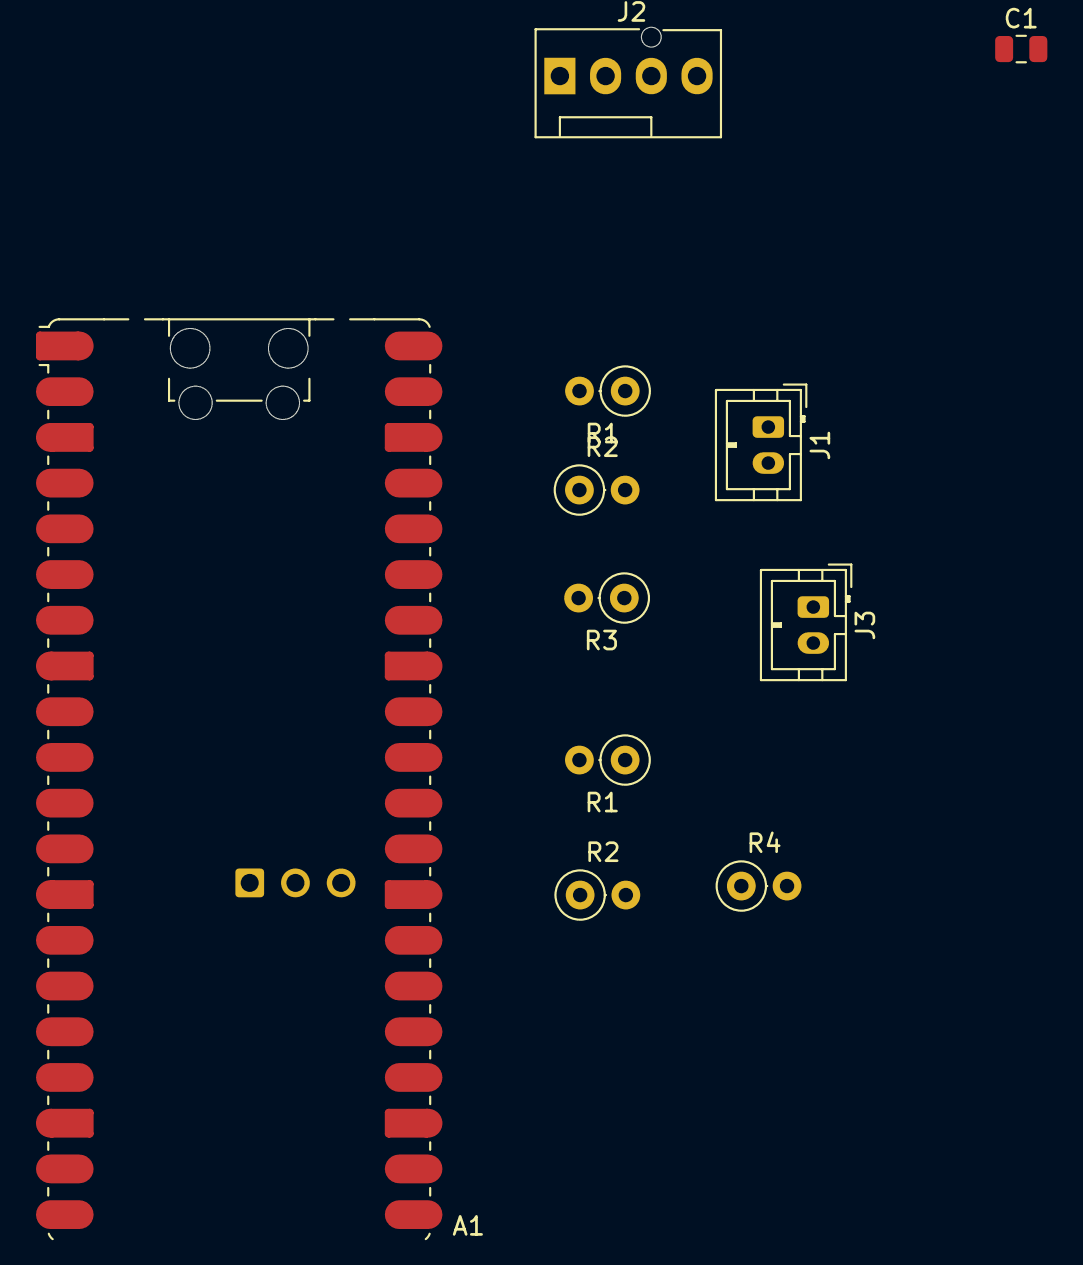
[picture p93: board Raspberry.kicad_pcb from above]

Board: 2 copper layers, 11 parts (0 on the bottom side), 8 nets.

Parts:
A1: RaspberryPi_Pico_W; RaspberryPi_Pico_W_SMD_HandSolder
C1: 100nF; C_0805_2012Metric
J1, J3: Conn_01x02_Pin; JST_PH_B2B-PH-K_1x02_P2.00mm_Vertical
J2: Conn_01x04; FanPinHeader_1x04_P2.54mm_Vertical
R1, R2, R2#2, R4: 10K; R_Axial_DIN0207_L6.3mm_D2.5mm_P2.54mm_Vertical
R1#2, R3: 22K; R_Axial_DIN0207_L6.3mm_D2.5mm_P2.54mm_Vertical

Connections:
+3.3V: C1.1, J2.3
ADC0: A1.31 (GPIO26_ADC0), R1#2.2, R2#2.1
ADC1: A1.32 (GPIO27_ADC1), R1.2, R2.1, R3.2, R4.1
Earth: A1.3 (GND), A1.8 (GND), A1.13 (GND), A1.18 (GND), A1.23 (GND), A1.28 (GND), A1.38 (GND), C1.2, J1.2, J2.4, R2.2, R2#2.2, R4.2
GP6: A1.9 (GPIO6), J2.2
GP7: A1.10 (GPIO7), J2.1
J1: J1.1, R1.1
J3 (1): R1#2.1, R3.1
