santiagoatejeda/Pleper/(commit log)

2025-11-16 inclucion de libreria LCD
    .
2025-11-16 Document progress on server integration with Raspberry Pi
    Added updates on the server integration and issues faced during development.
2025-11-16 Corrige errores y mejora redacción en Agosto.md
    Se corrigieron errores tipográficos y se mejoró la redacción de las contribuciones de los miembros del equipo.
2025-11-16 Actualización de la PCB, carpeta de campo
    [Raspberry.kicad_pcb, Raspberry.kicad_sch]
2025-11-16 Add entry for Ignacio Garcia Louzan's work
    Added a new entry for Ignacio Garcia Louzan regarding the design of the circuit box and emergency sign placement.
2025-11-16 Revisión de requisitos de cierre
2025-11-16 Organizo la documentación y archivos en sus correspondientes carpetas
    [Calendario_Tiempo de Procesos Proyecto 2025 (1).xlsx, Raspberry.kicad_pcb, Raspberry.kicad_sch]
2025-11-16 Ordeno las carpetas de código
    COMMIT N°500 VAMOSSSSSSSSSSSSSSSSSSSSSSSSSSSSSSSSSSSSSSSSSSSSSSSSSSSSSSSSSSSSSSSSSSSSSSSSSSSSSSSSSSSSSSSSSSSSSSSSSSSSSSSSSSSSSSSSSSSSSSSSSSSS
2025-11-16 Añado Licencia MIT al proyecto
    Un poco también para investigar y descubrir las cosas que se pueden hacer con GitHub
2025-11-16 Actualizo el avance en los requisitos de cierre
2025-11-17 Cortando tubo de PVC
2025-11-17 Cortando soportes para la estructura
2025-11-17 lijado de topes 3d
2025-11-17 Perforar la baldosa de madera
2025-11-17 Perforar placa de caucho
2025-11-17 Unir la placa de madera y caucho para la 2da placa
2025-11-17 delete pico sch y pcb
    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
    [Raspberry.kicad_pcb, Raspberry.kicad_sch]
2025-11-17 nuevo sch para la pico
    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
    [Raspberry.kicad_pcb, Raspberry.kicad_sch]
2025-11-17 Reacomodo el cv
2025-11-17 Actualizo cambios en requisitos de cierre y manual de usuario
2025-11-17 actualizacion de los elementos de alcance inconclusos
    ,
2025-11-17 Actualizo requisitos de cierre
2025-11-17 Pinte los bordes de la primera baldosa con aerosol
2025-11-17 Cortando bases de goma eva de la segunda baldosa
2025-11-17 Creacion de carpeta de presentaciones pleper
2025-11-17 Presentacion de pleper para la muestra
